dlgus0630/Project02_ControlRoom/Core/Src/main.c

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
/* Includes ------------------------------------------------------------------*/
#include "main.h"
#include "crc.h"
#include "dma2d.h"
#include "ltdc.h"
#include "spi.h"
#include "tim.h"
#include "usart.h"
#include "gpio.h"
#include "fmc.h"

/* USER CODE BEGIN Includes */
#include "app_control_room_fsm.h"   /* 관리실 메인 FSM(LCD/터치/RFID/RTC/RGB) */
#include "app_rs485_ctrl.h"         /* 엘리베이터 Modbus 마스터 */
/* USER CODE END Includes */


void SystemClock_Config(void);
/* USER CODE BEGIN 0 */

/* printf를 USART1(ST-Link 가상 시리얼포트)로 내보내는 함수.
   관리실 입장/퇴장 로그(app_control_room_fsm.c의 log_event())가 이걸 통해 찍힌다. */
int __io_putchar(int ch)
{
    if (ch == '\n')
        HAL_UART_Transmit(&huart1, (uint8_t *)"\r", 1, 0xFFFF);
    HAL_UART_Transmit(&huart1, (uint8_t *)&ch, 1, 0xFFFF);
    return ch;
}

/* USER CODE END 0 */

/**
  * @brief  The application entry point.
  * @retval int
  */
int main(void)
{

  /* MCU Configuration--------------------------------------------------------*/

  /* Reset of all peripherals, Initializes the Flash interface and the Systick. */
  HAL_Init();

  /* Configure the system clock */
  SystemClock_Config();

  /* Initialize all configured peripherals */
  MX_GPIO_Init();
  MX_CRC_Init();
  MX_DMA2D_Init();
  MX_FMC_Init();
  MX_LTDC_Init();
  MX_SPI5_Init();
  MX_USART1_UART_Init();
  MX_SPI4_Init();
  MX_UART5_Init();
  MX_TIM10_Init();
  /* USER CODE BEGIN 2 */
  RS485_Init();             /* 엘리베이터 통신(UART5 Modbus 마스터) 시작 */
  ControlRoom_FSM_Init();   /* LCD/터치/RFID/RTC/RGB 초기화 + 첫 화면 그리기 */
  /* USER CODE END 2 */

  /* Infinite loop */
  /* USER CODE BEGIN WHILE */
  while (1)
  {
    /* USER CODE END WHILE */

    /* USER CODE BEGIN 3 */
    ControlRoom_FSM_Update();   /* 화면/터치/RFID/상태전이 처리 */
    RS485_Update();             /* Modbus 폴링 상태머신 한 스텝 */
  }
  /* USER CODE END 3 */
}

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
/**
  * @brief  Period elapsed callback in non blocking mode
  * @note   This function is called  when TIM6 interrupt took place, inside
  * HAL_TIM_IRQHandler(). It makes a direct call to HAL_IncTick() to increment
  * a global variable "uwTick" used as application time base.
  * @param  htim : TIM handle
  * @retval None
  */
void HAL_TIM_PeriodElapsedCallback(TIM_HandleTypeDef *htim)
{
  if (htim->Instance == TIM6)
  {
    HAL_IncTick();
  }
}

/**
  * @brief  This function is executed in case of error occurrence.
  * @retval None
  */
void Error_Handler(void)
{
  /* USER CODE BEGIN Error_Handler_Debug */
  /* User can add his own implementation to report the HAL error return state */
  __disable_irq();
  while (1)
  {
  }
  /* USER CODE END Error_Handler_Debug */
}
#ifdef USE_FULL_ASSERT
/**
  * @brief  Reports the name of the source file and the source line number
  *         where the assert_param error has occurred.
  * @param  file: pointer to the source file name
  * @param  line: assert_param error line source number
  * @retval None
  */
void assert_failed(uint8_t *file, uint32_t line)
{
  /* USER CODE BEGIN 6 */
  /* User can add his own implementation to report the file name and line number,
     ex: printf("Wrong parameters value: file %s on line %d\r\n", file, line) */
  /* USER CODE END 6 */
}
#endif /* USE_FULL_ASSERT */
