dlgus0630/Project02_ControlRoom/BSP/Src/dev_rgb_led.c

#include "dev_rgb_led.h"
#include "main.h"   /* RGB_Red/Green/Blue 핀 + 포트 매크로 */

/* 보드가 LOW 레벨로 LED를 켜는 방식(공통 애노드)이면 1로 설정. */
#define RGB_ACTIVE_LOW   0

/* 한 채널을 구동. 배선이 액티브 로우면 레벨을 반전시킴. */
static void set_pin(GPIO_TypeDef *port, uint16_t pin, uint8_t on)
{
#if RGB_ACTIVE_LOW
    HAL_GPIO_WritePin(port, pin, on ? GPIO_PIN_RESET : GPIO_PIN_SET);
#else
    HAL_GPIO_WritePin(port, pin, on ? GPIO_PIN_SET : GPIO_PIN_RESET);
#endif
}

/* 색상값을 R/G/B 세 채널의 켜짐/꺼짐 조합으로 풀어서 GPIO에 바로 반영. */
static void apply_color(RGB_Color_t color)
{
    uint8_t r = 0, g = 0, b = 0;

    switch (color)
    {
        case RGB_BLUE:   b = 1;         break;
        case RGB_GREEN:  g = 1;         break;
        case RGB_YELLOW: r = 1; g = 1;  break;   /* 빨강 + 초록 = 노랑 */
        case RGB_RED:    r = 1;         break;
        case RGB_WHITE:  r = 1; g = 1; b = 1; break;   /* 빨강 + 초록 + 파랑 = 흰색 */
        case RGB_OFF:
        default:         break;   /* 정의되지 않은 값이 들어와도 안전하게 소등 */
    }

    set_pin(RGB_Red_GPIO_Port,   RGB_Red_Pin,   r);
    set_pin(RGB_Green_GPIO_Port, RGB_Green_Pin, g);
    set_pin(RGB_Blue_GPIO_Port,  RGB_Blue_Pin,  b);
}

void RGB_Init(void)
{
    apply_color(RGB_OFF);
}

void RGB_SetColor(RGB_Color_t color)
{
    apply_color(color);
}
