dlgus0630/Project02_ControlRoom/(commit log)

2026-07-27 Initial commit: Control Room (F429) standalone repo
    Split out of the shared team repo after a teammate's force-push
    wiped this project from its remote history. This repo is now
    independent so that risk doesn't recur. Captures the full current
    state: dashboard/FSM, RS-485 master, RFID, RTC, inspection mode,
    tiered error-code display, TIM10/PF6 fan PWM control.
    [Project02_Control_Room.ioc, app_control_room_fsm.c, app_control_room_fsm.h, app_rs485_ctrl.c, app_rs485_ctrl.h, dev_display_kr.c]
2026-08-04 Clean up stale and misleading comments
    Removes comments describing already-removed logic, translated-verbatim
    comments that add no information, and contradictory duplicate
    explanations. Rewrites kept comments for accuracy (FSM state meanings,
    Modbus register map, sensor/driver timing rationale) while keeping the
    project's existing Korean comment density.
2026-08-04 Remove dead code: unused RS485 accessor, glyph, and stale comments
    Drops the unused RS485_GetDhtStatus() accessor and its write-only
    backing variable, an unused KOR_CLEAR_EMG_BTN glyph no longer
    referenced after the unlock-button UI change (kept in sync across the
    glyph header, source, and generator script), an unused color macro,
    and stale/inaccurate comments across App/ and BSP/.
2026-08-14 Add README with troubleshooting photos and RS-485 logs
    Document the control room firmware: RS-485/Modbus RTU master protocol,
    FSM, screen composition, pin map, and troubleshooting notes.
    Include hardware photos for the LCD white-screen and I2C3 boot-hang
    cases, plus the RS-485 debug log captures from both boards.
2026-08-15 Fix SDRAM refresh count for the current 9MHz SDCLK
    REFRESH_COUNT was 542, computed back when SYSCLK was 72MHz
    (SDCLK 36MHz). SYSCLK is now 18MHz (SDCLK 9MHz), so that value
    refreshes about 4x less often than the IS42S16400J-7TL needs
    (~60us actual vs 15.62us required), risking framebuffer noise.
    Recompute for the current clock: (15.62us x 9,000,000) - 20 = 120.
    Safe direction (refreshes more often, still above the FMC minimum
    of 41). Update the stale comment, which still described the 72MHz
    setup, and note that this constant must be recomputed whenever
    SYSCLK changes.
    Also update README: mark stage 1 of the 13-5 fix as done, add a
    status column to the remediation table, add the timeline en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
